saiyashaskp006/AirDetection/backend/app/timeutil.py

from __future__ import annotations

from datetime import datetime, timezone


def utc_now() -> datetime:
    return datetime.now(timezone.utc)


def as_utc(value: datetime | None) -> datetime | None:
    if value is None:
        return None
    if value.tzinfo is None:
        return value.replace(tzinfo=timezone.utc)
    return value.astimezone(timezone.utc)


def iso(value: datetime | None) -> str | None:
    value = as_utc(value)
    return value.isoformat() if value else None
