saiyashaskp006/AirDetection/(commit log)

2026-11-08 fixed the root dir location
    [main.py, raspberry_pi.py, routes.py, schemas.py, services.py, websocket.py]
2026-11-12 arduino commit
2026-11-13 Enhance documentation and deployment setup for Raspberry Pi backend with MongoDB Atlas integration; update environment configurations and improve error handling in sensor reading process.
    [adc.py, config.py, main.py]
2026-11-14 Fix BMP280 I2C address in .env.example and update aerohub-backend.service for absolute paths
2026-11-14 mq7, mqq135 and GP2Y101AU0F sensor reading fixes and prev data fetrch from db.
    [adc.py, air_sensors.ino, config.py, defaults.py, estimates.py, hardware.py, main.py, raspberry_pi.py]
